EMIL-code-getin/desk-robot/hardware/pan-tilt-bracket/preview.png

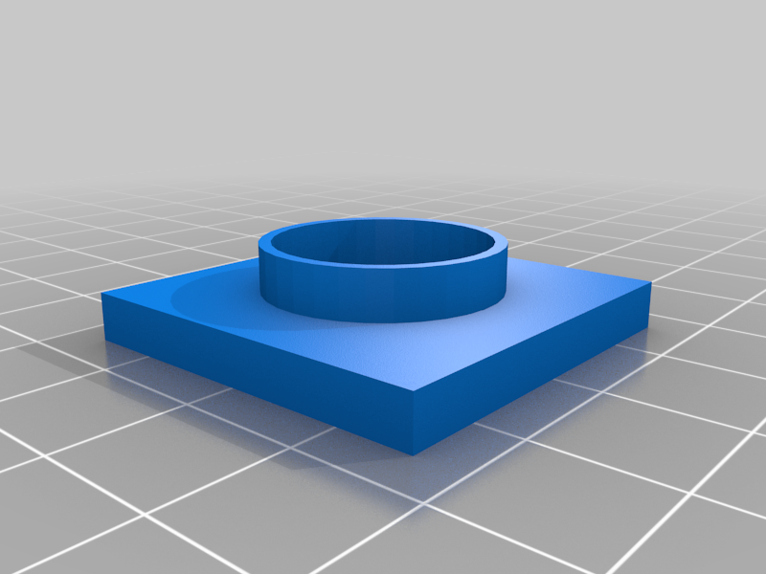
hardware/pan-tilt-bracket/preview.png
