EMIL-code-getin/desk-robot/README.md

# desk-robot

A small desk robot with a face, a voice, and a camera. Say "hey Rocky" and it
turns its head, looks at you, and answers out loud in character. The body is
a $24 microcontroller with an OLED screen on a pan-tilt neck. The brain is a
Python program on your computer that does speech-to-text, asks a language model,
and speaks the reply through the robot's speaker.

<!-- photo or short clip goes here: docs/rocky.jpg -->

## Versions

**V1 is the robot in the videos.** It is frozen as the
[v1.0 release](https://github.com/cgro00/desk-robot/releases/tag/v1.0), a
permanent snapshot of the code, wiring, and parts list as built. `main` is
always the latest version and may be ahead of what an older video shows.
[CHANGELOG.md](CHANGELOG.md) lists what changed between versions.

Out of the box it is **Rocky**, the Eridian engineer from *Project Hail
Mary*: short sentences, "question" and "answer", "amaze", and constant
worry about whether you have slept. Everything about him is yours to change.
See [Make it your own](#make-it-your-own).

**What it can do**

- Wake on its name, listen, and answer with a spoken reply in a cloned voice.
- Show seven expressions on its face, blink, and doze off when ignored.
- Turn and nod its head, follow your face, and look where you ask.
- See through its camera and tell you what is there, honestly.
- Decide when you have finished talking, the way a person does, instead of
  waiting for a fixed pause.

**How it is put together**

```
┌──────────────── the robot (XIAO ESP32S3 Sense) ───────────────┐
│  OLED face · pan/tilt servos · camera · mic · amp + speaker   │
└───────────────────────────┬───────────────────────────────────┘
                            │ WiFi (WebSocket)
┌───────────────────────────┴───────────────────────────────────┐
│  brain server (Python, on your computer)                      │
│  wake word → speech-to-text → language model → text-to-speech │
│  plus face tracking, emotions, and head movements             │
└───────────────────────────────────────────────────────────────┘
```

The firmware is deliberately simple: it draws the face, moves the servos,
and streams audio and camera frames. All the judgement lives in `server/`.
Nothing is billed while the robot is idle.

## Contents

1. [What you need](#what-you-need)
2. [Build the body](#build-the-body)
3. [Flash the firmware and test over USB](#flash-the-firmware-and-test-over-usb)
4. [Set up the brain on your computer](#set-up-the-brain-on-your-computer)
5. [Connect the robot to the brain](#connect-the-robot-to-the-brain)
6. [Living with Rocky](#living-with-rocky)
7. [Make it your own](#make-it-your-own)
8. [Troubleshooting](#troubleshooting)
9. [How it works](#how-it-works)
10. [Privacy and security](#privacy-and-security)
11. [Credits and license](#credits-and-license)

## What you need

**Parts.** Roughly $100 in total, plus a soldering iron if you do not have
one. Everything is a common Amazon or Adafruit item.

| Part | Notes |
| --- | --- |
| Seeed XIAO ESP32S3 **Sense** | The Sense version has the camera and microphone built in. Get it with headers pre-soldered if you can. The little U.FL antenna in the box is required for WiFi. |
| 1.3" SH1106 I2C OLED, 128x64 | The face. The 0.96" SSD1306 also works with a one-line firmware change. |
| Adafruit Mini Pan-Tilt kit, assembled | The neck. It ships with two SG90 servos, which work. MG90S metal-gear servos are a drop-in upgrade for smoother motion. |
| MAX98357A I2S amplifier board | Turns digital audio into speaker power. The $3 clones work. |
| Small 4 Ω 3 W speaker | Enclosed ones with a JST lead are easiest to mount. |
| 470 to 1000 µF electrolytic capacitor | Keeps the servos from browning out the board. Not optional. |
| Breadboard, jumper wires, M2/M2.5 nylon standoffs | For wiring and mounting the screen. |
| 5 V, 2 A or better USB-C power supply | A laptop port is fine for flashing, not for running servos and speaker. |

**On the computer side.**

- A Mac, Windows PC, or Linux machine on the same WiFi as the robot. It was
  built and tested on an Apple Silicon Mac. Windows and Linux use the same
  code except for the built-in fallback voice and speaker playback, which
  have their own paths that nobody has run yet. If you're the first, say how
  it went. On Linux, install `espeak-ng` for the fallback voice.
- Python 3.13, which is what this was built and tested with.
- PlatformIO for flashing the firmware (installed below).
- A language-model API key. Any one of these works:
  - **OpenRouter** (the default): one key, any model, easy to switch.
  - **Anthropic**: use a Claude model directly.
  - **OpenAI**: use a GPT model directly.
- Optionally a **Fish Audio** key for the cloned voice. Without it Rocky
  speaks with your computer's built-in voice, which is fine for getting
  started.

**Skills.** Basic soldering (about 27 joints, all through-hole), and the
patience to read the wiring guide before powering anything on.

## Build the body

Follow [`docs/wiring.md`](docs/wiring.md) with the parts in hand. The short
version:

1. Everything shares a ground rail.
2. Servos and the amplifier run from the XIAO's **5 V** pin, never 3.3 V.
3. The big capacitor goes across 5 V and ground, striped leg to ground.
4. The OLED is on I2C (D4/D5), the servos on D3 (pan) and D6 (tilt), the
   amplifier on D0, D1, D2.
5. The camera and microphone are on the Sense board already. No wiring.

Only the OLED and the XIAO ride on the pan-tilt head. The amplifier,
speaker, breadboard, and capacitor stay on the desk. There is no printed
shell yet, so mount the screen on a small plate on the tilt platform with
standoffs or foam tape, with the camera peeking over the top edge.

## Flash the firmware and test over USB

Do this before WiFi. It proves the face and the neck work.

1. Install PlatformIO, either as the VS Code extension or from the terminal:

   ```bash
   brew install platformio
   ```

2. Plug the XIAO in over USB-C, then build and flash:

   ```bash
   cd firmware
   pio run -t upload
   pio device monitor        # serial console at 115200
   ```

3. The eyes should open, blink, and look around on their own. In the serial
   console, try:

   ```
   help                 list commands
   emo happy            change the face: neutral/happy/sad/angry/surprised/sleepy/thinking
   pan -30              turn the head, -60..60, 0 = center
   tilt -20             nod the head, -60 (down)..0 (level)
   blink                blink once
   demo off             stop the idle behaviour
   raw tilt 20          calibration move that ignores the limits (watch it!)
   ```

4. Check the head's manners. If `tilt -20` looks up instead of down, flip
   `TILT_INVERT` in `firmware/include/config.h`. If the head is not straight
   or level at 0, adjust `PAN_TRIM_DEG` and `TILT_TRIM_DEG` a few degrees at
   a time. If the tilt bracket strains at the end of its travel, pull the
   `TILT_MIN_DEG` and `TILT_MAX_DEG` limits in. Re-flash after each change.

Without a `secrets.h` file the firmware stays in this USB-only mode, which
is useful whenever you want to test the body alone.

## Set up the brain on your computer

The brain works without the robot: it uses your computer's microphone and
speaker until the robot connects. Get it talking first.

```bash
cd server
python3 -m venv .venv
source .venv/bin/activate          # Windows: .venv\Scripts\activate
pip install -r requirements.txt
cp .env.example .env               # Windows: copy .env.example .env
```

Open `server/.env` and fill in:

- `LLM_API_KEY`: your OpenRouter key. (For Anthropic or OpenAI instead, see
  [Change the model or provider](#change-the-model-or-provider).)
- `HUMAN_NAME`: what Rocky should call you.
- `ROBOT_TOKEN`: any random string. The robot will need the same one. Make
  one with `python3 -c "import secrets; print(secrets.token_hex(16))"`.
- `FISH_AUDIO_API_KEY`: optional, for the cloned voice.

Then start it, from the `server` folder with the venv active:

```bash
python -m brain.main
```

The first run downloads about 160 MB of speech models into `~/.cache`
(Whisper from Hugging Face, the two turn-detection models from GitHub and
Hugging Face, all pinned to a fixed version). macOS will ask once to let
your terminal use the microphone; on Windows, check that microphone access
for desktop apps is on in Privacy settings. Say **"hey Rocky, what is a
weekend?"** and he should answer through your computer's speaker. You can
also type `ask what is a weekend?` into the server console.

The live view at <http://localhost:8766/> is Rocky's console: what he sees,
what he hears, the last exchange, and controls for his head, face, voice,
sleep, and listening. It only answers this computer.

## Connect the robot to the brain

1. Find your computer's address on your WiFi:

   ```bash
   ipconfig getifaddr en0     # macOS
   ipconfig                   # Windows: the IPv4 address of your WiFi adapter
   hostname -I                # Linux
   ```

   Your router can usually pin the computer to a fixed address so this does
   not change.

2. Copy `firmware/include/secrets.h.example` to `secrets.h` in the same
   folder and fill in your WiFi name and password, that address, and
   the same `ROBOT_TOKEN` you put in `server/.env`. The ESP32 only sees
   **2.4 GHz** networks.

3. Flash again with `pio run -t upload`. The serial console shows
   `wifi: connected` and then `brain: connected` once the server is running.

From then on the server listens through the robot's microphone and speaks
through the robot's speaker whenever the robot is connected, and falls back
to your computer when it is not. The robot can now live on a wall supply
away from the computer.

## Living with Rocky

| Say | What happens |
| --- | --- |
| "hey Rocky" | He wakes, looks up, and waits for your question. His name alone, without "hey", does not wake him. |
| anything, while he is awake | He answers. No need to repeat his name for about a minute. |
| "Rocky, look left" / "look at the door" | He turns his head, takes a fresh picture, and tells you what he sees. |
| "what do you see?" | He describes the current camera frame, and only what is actually in it. |
| "track me" / "stop tracking" | His head follows your face, or stops. |
| "Rocky, sleep" / "goodnight" | He says goodnight and stops listening until you say his name. |

He decides you are finished the way a person does. A small model listens to
how your sentence ends; if you sound done he answers about a third of a
second later, and if you trail off he waits. His first sentence is spoken
while the rest is still being written. If you start talking again before he
speaks, he drops the reply and answers the whole thing once. Once he is
speaking he finishes the line, because his microphone is muted while his
own voice plays.

Server console commands, for when talking is inconvenient:

```
ask <question>       talk to Rocky from the keyboard
say <text>           speak exactly this
volume 0.5           speaker volume, 0 to 1
listen               toggle the microphone
mic                  three-second level meter
track on|off         face tracking
emo surprised        push a face
pan 20 / tilt -20    move the head
status               what is connected
```

Every reply prints a `timing` line so you can see where the seconds go.

## Make it your own

Everything below is a one-file edit. None of it needs the robot plugged in,
so you can tune the character with `ask` in the server console before the
body is even built.

### Rename the robot

`ROBOT_NAME` in `server/brain/config.py`. The wake word becomes "hey
<name>" and the sleep phrases and speech-to-text hint follow automatically.
Update `WAKE_PHRASES` in the same file with the ways speech-to-text tends
to mishear the new name (say it a few times and watch the console). The
character file still introduces itself as Rocky, so edit
`server/brain/personality.py` too, or you have a robot called Bolt who
insists he is Rocky.

### Change the character

`server/brain/personality.py` is the whole personality: one system prompt
that pins down who he is and how he talks, plus a few canned lines for
waking, sleeping, and tracking. To make a different character, rewrite the
prompt. The parts worth keeping are the rules about being honest with the
camera, the emotion tag at the start of every reply, and the sentence
limit, because the face, the voice, and the cost all depend on them. Add
real exchanges that came out well to the examples at the bottom; they do
more than the rules do.

`REPLY_MAX_SENTENCES` in `config.py` caps how much he says per turn. The
server cuts anything past it before it is spoken.

### Change the voice

Rocky's voice is a community-uploaded fan clone on
[Fish Audio](https://fish.audio), not something this project owns. It may
disappear one day, and it is for personal use. Open any voice's page there,
copy the 32-character ID from the URL into `TTS_VOICE_ID` in `config.py`,
and put your Fish key in `server/.env`.
`TTS_TEMPERATURE` and `TTS_TOP_P` trade steadiness for expressiveness.
Without a Fish key he uses the computer's built-in voice: on macOS,
`TTS_FALLBACK_VOICE` picks one (`say -v ?` lists them); Windows uses its
default voice; Linux uses `espeak-ng` if installed.

The robot's speaker is tiny, so a deep voice turns into rattle. Three knobs
in `config.py` shape the audio before it reaches the speaker: `TTS_LEVEL`
(loudness he is held to), `TTS_HIGHPASS_HZ` (bass cut, try 250 to 350 for a
deep voice), and `TTS_PRESENCE_DB` (lift for a muffled voice). The console
page has sliders for all three so you can dial them in while he talks, then
copy the winners into config. If a voice keeps misbehaving, `DEBUG_SAVE_TTS`
in `config.py` keeps the last 30 spoken clips and their text in
`server/debug/tts/` (git-ignored) so you can listen back.

### Change the model or provider

The brain speaks the OpenAI-style chat API, which OpenRouter, Anthropic, and
OpenAI all serve. Pick one in `config.py`:

| Provider | `LLM_BASE_URL` | `MODEL` example | Key in `.env` |
| --- | --- | --- | --- |
| OpenRouter (default) | `https://openrouter.ai/api/v1` | `anthropic/claude-haiku-4.5` | OpenRouter key |
| Anthropic | `https://api.anthropic.com/v1/` | `claude-haiku-4-5` | Anthropic key |
| OpenAI | `https://api.openai.com/v1` | `gpt-4.1-mini` | OpenAI key |

Whichever you choose, the key goes in `LLM_API_KEY` in `server/.env`. The
model must accept images (Rocky sends camera frames) and tool calls (he
moves his head with them). A small, fast model is the right choice here:
replies are three sentences, and character matters more than reasoning.
Haiku has been the best at staying in character; a few dollars a month
covers a lot of chatting. The project was built and tested through
OpenRouter. Anthropic documents streaming, tool calls, and image input on
its OpenAI-compatible endpoint, which is everything this project uses, but
describes it as a compatibility layer rather than the main road.

### Change how he listens

Also in `config.py`: `VAD_THRESHOLD` (how loud counts as speech),
`TURN_THRESHOLD` and `TURN_MAX_SILENCE` (how sure he needs to be that you
are done, and how long he will wait), `AWAKE_SECONDS` (how long he stays
awake after you speak), `STT_MODEL` (`base.en` is fast; `small.en` hears
better and takes about a second longer), and `MIC_DEVICE` in `.env` if the
computer should use a specific microphone. The console page has sliders for the
listening knobs; changes apply immediately and last until restart.

### Change the body

`firmware/include/config.h` has the pin map, the head's range and speed
limits, servo trims, speaker volume, microphone gain, and camera flips. The
OLED driver line is near the top of `firmware/src/main.cpp` if you use a
different panel. The expressions themselves are drawn in `face.cpp`.

## Troubleshooting

- **The OLED stays black.** SDA and SCL are swapped, or a jumper is loose.
- **The board reboots when the head moves.** The servos are on 3.3 V, or the
  capacitor is missing, or you are on a laptop USB port. Use a 5 V 2 A supply.
- **`wifi: joining` forever.** The network is 5 GHz only, or the antenna is
  not clipped on. Make a 2.4 GHz network or band.
- **The robot prints `brain: connected` then `brain: disconnected, will
  retry` every few seconds.** `ROBOT_TOKEN` differs between `server/.env`
  and `secrets.h`. The server console shows the refusal. If it never gets
  to `brain: connected`, the computer's address changed or the server is
  not running.
- **He never hears you on the computer.** On macOS, check System Settings,
  Privacy & Security, Microphone for your terminal; on Windows, the
  microphone privacy setting for desktop apps. Run `mic` in the server console
  for a level meter. If you have several inputs, set `MIC_DEVICE` in `.env`.
- **"Brain has no key."** `LLM_API_KEY` is empty, or belongs to a different
  provider than `LLM_BASE_URL`.
- **He answers in the computer's voice.** `FISH_AUDIO_API_KEY` is missing
  or the voice ID is wrong. Fine for testing; set it when you want the real
  voice.
- **"cannot speak: no built-in voice on this system."** Linux without
  `espeak-ng`. Install it, or set a Fish key.
- **The voice rattles or sounds muffled.** Use the speaker-tuning sliders on
  the console page, then copy the values into `config.py`.
- **He cuts you off, or waits too long.** Raise `TURN_THRESHOLD` if he jumps
  in early, lower it if he waits. `TURN_MAX_SILENCE` is his patience limit.
- **First start is slow.** It is downloading the speech models. Only once.

## How it works

- **Firmware** (`firmware/src/`): `face.cpp` draws the eyes and mouth at 30
  fps, `servo_neck.cpp` eases the head with speed limits, `camera.cpp`
  keeps the latest JPEG in memory, `mic.cpp` streams 16 kHz audio, and
  `speaker.cpp` plays whatever the brain sends. `link.cpp` is the WebSocket
  client. The USB serial console and the brain drive the same commands.
- **Brain** (`server/brain/`): `ears.py` turns audio into text with
  faster-whisper, using Silero VAD to find speech and Smart Turn
  (`turn.py`) to decide when you have finished. `thinking.py` talks to the
  model, streams the reply sentence by sentence, and gives the model two
  tools: `look` (move the head, take a picture) and `track_face`.
  `mouth.py` turns text into audio with Fish Audio and levels it for the
  small speaker. `tracker.py` follows faces with OpenCV. `eyes.py` serves
  the console page. `main.py` ties it together.
- **Protocol** between the two is in [`docs/protocol.md`](docs/protocol.md):
  JSON commands one way, audio and JPEG frames the other.

Tests run with no hardware and no downloads:

```bash
cd server && python -m unittest tests/test_personality.py tests/test_segmenter.py
```

## Privacy and security

- **Secrets stay in two git-ignored files**: `server/.env` and
  `firmware/include/secrets.h`. Never commit them, and do not share
  `firmware/.pio/` build output either: the compiled binary contains your
  WiFi password.
- **Only your robot can talk to the brain.** The WebSocket port is open on
  your LAN, but the first message must carry `ROBOT_TOKEN`. One robot at a
  time.
- **The camera console is this computer only** and rejects requests from other
  hosts. Opening it to the LAN would let anyone on your WiFi watch the
  camera and read transcripts.
- **Voice is unauthenticated by design.** Anyone in earshot can say "hey
  Rocky". All he can do is move his head and spend a fraction of a cent.
- **What leaves your computer:** each question sends the transcript, the recent
  conversation, your name from `HUMAN_NAME`, and the newest camera frame
  (only for visual questions) to your model provider, and each reply's text
  to Fish Audio if configured. Speech-to-text and face tracking run
  locally. The first run downloads speech models from Hugging Face and
  GitHub, pinned to fixed versions. The console page loads nothing from the
  internet.
- **What is stored:** the in-memory conversation, and nothing else unless
  you turn on `DEBUG_SAVE_TTS` or `DEBUG_SAVE_UTTERANCE` in `config.py`,
  which keep recent spoken replies or the last thing heard in
  `server/debug/` (git-ignored).
- **Known limitation:** robot-to-computer traffic is a plain WebSocket on
  your home network. Someone already on your WiFi who spoofs the computer's address
  could command the robot and receive its streams. Mutual authentication or
  TLS is the fix if that matters to you.

## Credits and license

- Face detection is [YuNet](https://github.com/opencv/opencv_zoo/tree/main/models/face_detection_yunet)
  (`server/models/`), Apache 2.0, by Shiqi Yu and the OpenCV Zoo
  contributors.
- Speech detection is [Silero VAD](https://github.com/snakers4/silero-vad)
  (MIT) and end-of-turn detection is
  [Smart Turn](https://github.com/pipecat-ai/smart-turn) (BSD-2-Clause).
  Both download on first run. `server/brain/whisper_features.py` is
  vendored from Smart Turn (Daily, BSD-2-Clause), itself derived from
  HuggingFace transformers (Apache 2.0).
- Rocky and his voice are fan work. *Project Hail Mary* belongs to Andy Weir.

MIT licensed. See [`LICENSE`](LICENSE). Build one, change everything, tell
me what it turned into.
