EMIL-code-getin/desk-robot/hardware/pan-tilt-bracket/minimalized_pan_tilt_tower_pro_9g_20_critical_update.stl

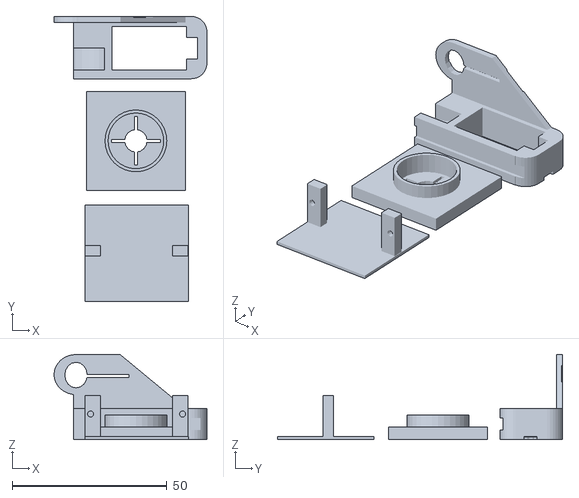
[picture p2: CAD file, 2026-09-24]
hardware/pan-tilt-bracket/minimalized_pan_tilt_tower_pro_9g_20_critical_update.stl
49.5 x 92.3 x 27.5
