EMIL-code-getin/desk-robot/hardware/pan-tilt-bracket/pan_tilt_for_tower_pro_9g_servo_sg90_base.stl

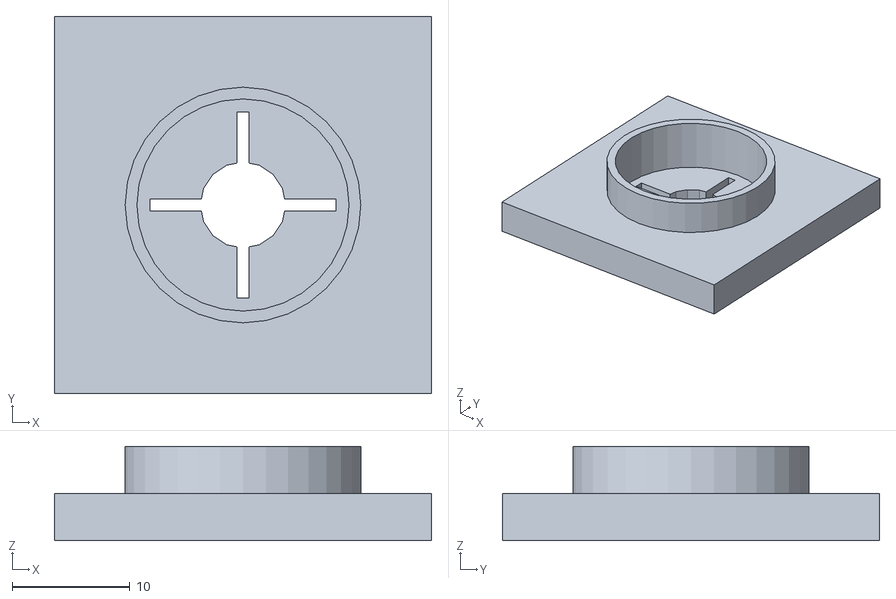
[picture p3: CAD file, 2026-09-24]
hardware/pan-tilt-bracket/pan_tilt_for_tower_pro_9g_servo_sg90_base.stl
32.0 x 32.0 x 8.00
