EMIL-code-getin/desk-robot/hardware/pan-tilt-bracket/minimalized_pan_tilt_tower_pro_9g_face.stl

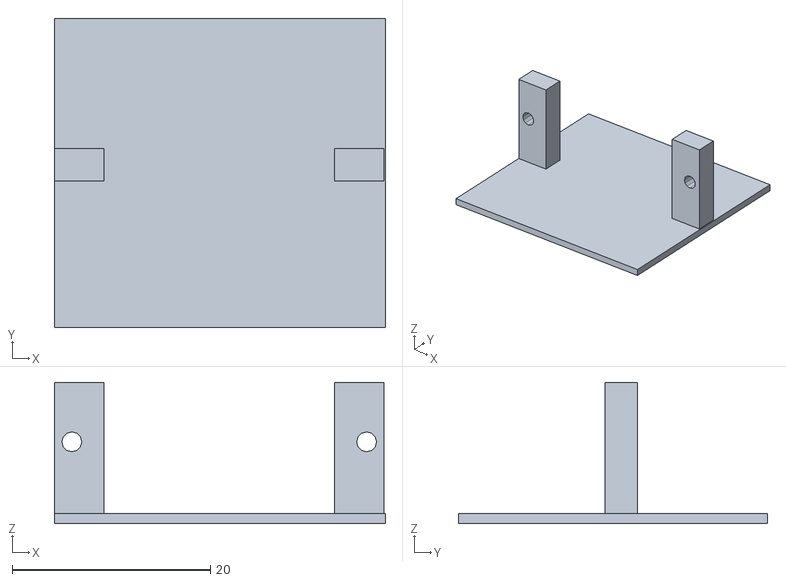
[picture p4: CAD file, 2026-09-24]
hardware/pan-tilt-bracket/minimalized_pan_tilt_tower_pro_9g_face.stl
33.4 x 31.2 x 14.3
