EMIL-code-getin/desk-robot/hardware/pan-tilt-bracket/minimalized_pan_tilt_tower_pro_9g_v20_critical_update.stl

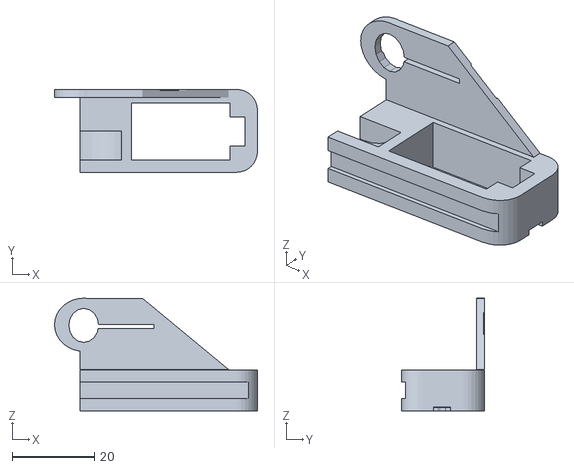
[picture p5: CAD file, 2026-09-24]
hardware/pan-tilt-bracket/minimalized_pan_tilt_tower_pro_9g_v20_critical_update.stl
49.5 x 20.3 x 27.5
