EMIL-code-getin/desk-robot/firmware/include/config.h

#pragma once

// ─── Pin map (XIAO ESP32S3 Sense) ────────────────────────────────────────────
// Silkscreen label → GPIO number. The camera, PDM mic, and SD slot on the
// Sense expansion board use their own internal pins and don't appear here.
//
//   D0  = GPIO1   I2S BCLK  → MAX98357A BCLK      (speaker)
//   D1  = GPIO2   I2S LRC   → MAX98357A LRC       (speaker)
//   D2  = GPIO3   I2S DIN   → MAX98357A DIN       (speaker)
//   D3  = GPIO4   pan servo signal (orange wire)
//   D4  = GPIO5   I2C SDA   → OLED SDA
//   D5  = GPIO6   I2C SCL   → OLED SCL
//   D6  = GPIO43  tilt servo signal (orange wire)
//   D7  = GPIO44  spare

constexpr uint8_t PIN_SERVO_PAN = 4;   // D3
constexpr uint8_t PIN_SERVO_TILT = 43; // D6

constexpr uint8_t PIN_I2S_BCLK = 1; // D0 → MAX98357A BCLK
constexpr uint8_t PIN_I2S_LRC = 2;  // D1 → MAX98357A LRC
constexpr uint8_t PIN_I2S_DIN = 3;  // D2 → MAX98357A DIN

// I2C uses the XIAO's default Wire pins (SDA=GPIO5/D4, SCL=GPIO6/D5).
// Most SH1106 modules answer at address 0x3C; U8g2 finds it automatically.

// ─── Motion limits ───────────────────────────────────────────────────────────
constexpr float PAN_MIN_DEG = -60.0f; // head turn limit, left
constexpr float PAN_MAX_DEG = 60.0f;  // head turn limit, right
constexpr float PAN_MAX_SPEED = 180.0f; // deg/sec ceiling — keeps motion gentle
constexpr float PAN_TRIM_DEG = 0.0f;    // tweak if the head isn't straight at 0

// The reference build: the tilt platform hits the pan servo body if it tries to
// look above eye level, so 0 (eye level) is the ceiling and it only nods down.
constexpr float TILT_MIN_DEG = -60.0f;  // look-down limit
constexpr float TILT_MAX_DEG = 0.0f;    // look-up limit (eye level is the mechanical stop)
constexpr float TILT_MAX_SPEED = 120.0f;
constexpr float TILT_TRIM_DEG = 0.0f;   // tweak so the head sits level at 0
constexpr bool TILT_INVERT = true;      // flip if `tilt -20` looks up instead of down
                                        // (true on the Adafruit pan-tilt with the OLED facing forward)

// Watch the mechanism the first time tilt moves: if the bracket strains at
// either end of travel, pull TILT_MIN/MAX in until it stops.

// Detach the servo after it has been at rest this long. A detached servo
// doesn't buzz or burn power; the head is light enough to hold position.
constexpr uint32_t SERVO_RELAX_MS = 1500;

// ─── Microphone ──────────────────────────────────────────────────────────────
// The Sense board's PDM mic is hard-wired to these GPIOs (no header pins).
constexpr uint8_t PIN_PDM_CLK = 42;
constexpr uint8_t PIN_PDM_DATA = 41;
// Software gain on the mic samples. The PDM mic is quiet; raise if the brain
// says "too quiet", lower if loud speech clips.
constexpr float MIC_GAIN = 6.0f;

// ─── Camera ──────────────────────────────────────────────────────────────────
// The camera is mounted ribbon-up on the head, which puts the sensor upside
// down: flip + mirror = rotate 180 degrees.
constexpr bool CAMERA_VFLIP = true;
constexpr bool CAMERA_HMIRROR = true;

// ─── Speaker ─────────────────────────────────────────────────────────────────
// 0.0-1.0 software volume for the MAX98357A. For more than 1.0 can give,
// tie the amp's GAIN pin to GND (15 dB instead of the floating 9 dB).
constexpr float SPEAKER_VOLUME = 0.7f;

// ─── Behavior ────────────────────────────────────────────────────────────────
constexpr uint32_t FRAME_INTERVAL_MS = 33; // ~30 FPS face animation
