EMIL-code-getin/desk-robot/firmware/src/face.h

#pragma once

#include <Arduino.h>
#include <U8g2lib.h>

// Expressive two-eye face for a 128x64 mono OLED.
//
// Eyes are rounded rectangles whose shape morphs smoothly between emotion
// presets. Layered on top: blinks, gaze shifts, a glint in each eye, a mouth
// that moves with the speaker's audio, per-emotion flourishes ("!" pop,
// blush, tears, thinking dots, angry shake), and a sleep state with slow
// breathing and floating Z's.

enum class Emotion : uint8_t {
  Neutral,
  Happy,
  Sad,
  Angry,
  Surprised,
  Sleepy,
  Thinking,
  COUNT,
};

const char* emotionName(Emotion e);
bool emotionFromName(const char* name, Emotion& out);

class Face {
 public:
  explicit Face(U8G2& display) : u8g2_(display) {}

  void begin();
  void setEmotion(Emotion e);
  Emotion emotion() const { return emotion_; }
  void blink();

  // Asleep: eyes shut, breathing, Z's. Overrides the emotion while on.
  void setAsleep(bool on);
  bool asleep() const { return asleep_; }

  // Talking: draws a mouth that opens with `level` (0..1, the speaker's
  // current loudness). Call every frame while audio plays.
  void setTalking(bool on, float level = 0.0f);

  // When idle behavior is on, the face blinks and glances around on its own.
  void setIdle(bool on) { idle_ = on; }

  // Call every frame: advances animation, then renders.
  void update(uint32_t nowMs);

 private:
  // The morphable parameters of one emotion. All units are pixels.
  struct Params {
    float eyeW;      // eye width
    float eyeH;      // eye height
    float radius;    // corner rounding
    float browSlant; // top edge tilt: >0 inner corners drop (angry), <0 outer (sad)
    float lowerLid;  // pushes up from below → happy crescent
    float upperLid;  // droops from above → sleepy
  };

  struct Zed {
    bool alive = false;
    float x = 0, y = 0;
    float age = 0;  // 0..1 over its life
  };

  static Params paramsFor(Emotion e);
  void stepAnimation(uint32_t nowMs);
  void render();
  void drawEye(int cx, int cy, bool isLeft, float hScale);
  void drawMouth(int cx, int cy);
  void drawFlourishes(int leftCx, int rightCx, int cy, int eyeTop, int eyeBottom);
  void drawZeds();

  U8G2& u8g2_;
  Emotion emotion_ = Emotion::Neutral;
  Params cur_ = paramsFor(Emotion::Neutral);
  Params target_ = paramsFor(Emotion::Neutral);
  uint32_t emotionSinceMs_ = 0;

  // Blink state: 0 = open, 1 = fully closed.
  float blinkAmount_ = 0.0f;
  bool blinkClosing_ = false;
  uint32_t nextBlinkMs_ = 0;

  // Gaze offset from center, eased toward gazeTarget.
  float gazeX_ = 0, gazeY_ = 0;
  float gazeTargetX_ = 0, gazeTargetY_ = 0;
  uint32_t nextSaccadeMs_ = 0;

  // Flourish state.
  float pop_ = 0.0f;            // overshoot on emotion change, decays to 0
  float squint_ = 0.0f;         // 1 while squinting, decays
  uint32_t nextSquintMs_ = 0;
  float tearY_ = -1.0f;         // -1 = no tear; else its y
  uint32_t nextTearMs_ = 0;
  uint8_t thinkDots_ = 0;
  uint32_t nextDotMs_ = 0;
  int jitterX_ = 0;

  // Sleep.
  bool asleep_ = false;
  float breath_ = 0.0f;         // phase
  Zed zeds_[3];
  uint32_t nextZedMs_ = 0;
  uint32_t nextTwitchMs_ = 0;
  float twitch_ = 0.0f;

  // Mouth.
  bool talking_ = false;
  float mouthLevel_ = 0.0f;
  float mouth_ = 0.0f;          // eased openness 0..1

  bool idle_ = true;
  uint32_t lastFrameMs_ = 0;
  uint32_t frame_ = 0;
};
