EMIL-code-getin/desk-robot/(commit log)

2026-09-06 Rocky: desk robot with face, voice, camera, and a Claude brain
    First commit of the working robot. XIAO ESP32S3 Sense on a pan-tilt neck
    with an OLED face, MAX98357A speaker, PDM mic, and camera; a Python brain
    server on the Mac does wake word, speech-to-text, Claude Haiku 4.5 via
    OpenRouter, Fish Audio voice, live camera view, and face tracking.
    Firmware (PlatformIO, firmware/):
    - face: morphing eyes, blinks, glints, mouth driven by speaker level,
    per-emotion flourishes, sleep state with breathing and Z's
    - servos: pan/tilt easing with idle glances and auto-relax; tilt capped
    at eye level for this build
    - link: WiFi + WebSocket to the brain, shared-token hello, JSON commands
    mapped on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
2026-09-07 Rocky talks like a conversation: streaming replies, real turn detection, head fixes
    Server
    - Replies stream end to end: the model's sentences go to Fish Audio one at a
    time, Fish's PCM streams to the robot as it is generated (speak_begin with
    bytes 0), and the face changes before the first sentence. First sound now
    arrives ~1.7 s after the question instead of ~4-5 s.
    - Turn detection replaces the fixed 0.9 s silence wait: Silero VAD decides
    what is speech and Smart Turn v3.2 judges after a 0.2 s pause whether you
    sound finished, waiting up to TURN_MAX_SILENCE if you trail off. Both are
    small ONNX models (new brain/turn.py, numpy Whisper features vendored from
    Pipecat under BSD-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
    [config.h, main.cpp, servo_neck.cpp, servo_neck.h]
2026-09-07 Live-view console, honest camera answers, level voice, head fixes
    - New live view (brain/liveview.html, served by eyes.py): a Hail Mary style
    console showing what Rocky sees (reticle follows head pose, red glow while
    he speaks), a rolling "Rocky hears" sound strip, the last exchange, and
    controls for head, face, voice, sleep and listening tuning. Controls go
    through POST /api/<action>, guarded by the Host check plus a custom header
    and Origin check so no other site can drive the robot. Tunable config keys
    are allowlisted (main.py TUNABLE) and change live until restart.
    - Camera answers are honest: a picture is attached only for questions that
    are actually about seeing (C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
    [main.cpp, servo_neck.cpp]
2026-09-18 Rocky only again, plus public-release prep
    - Remove the TARS persona and all switching (spoken "switch to", the
    console `be` command, the live-view Who card). Rocky's prompt and
    canned lines are the single character again. The speaker tuning that
    came with that work stays as flat config knobs (TTS_LEVEL,
    TTS_HIGHPASS_HZ, TTS_PRESENCE_DB) with the console sliders.
    - HUMAN_NAME is read from server/.env (default "friend") so a real name
    never lands in the repo.
    - MIT license, README credits for YuNet / Silero VAD / Smart Turn, and
    the stray tool session file ignored.
    - Ears: a missing Mac mic no longer stops the robot mic from working;
    softer threshold once speech has started so q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
    [config.h, main.cpp]
2026-09-18 Public-release audit fixes
    - A blank value in server/.env no longer shadows the default, so a fresh
    copy of .env.example starts the server instead of crashing it.
    - Model provider is configurable (LLM_BASE_URL + MODEL in config.py,
    LLM_API_KEY in .env): OpenRouter by default, Anthropic or OpenAI direct.
    - Privacy: debug clip saving off by default; console page loads nothing
    from the internet (system fonts, no-referrer); Whisper model pinned to a
    fixed commit like the other two; README lists everything that leaves the
    Mac and what is stored.
    - Hardening: token compared as bytes, Content-Length range-checked,
    temperature coerced to a number, nosniff on image responses.
    - MIC_DEVICE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
    [config.h, link.h, main.cpp]
2026-09-18 Run the brain on Windows and Linux too
    - Built-in fallback voice picks the engine by platform: macOS `say`,
    Windows' speech engine through PowerShell, espeak-ng on Linux. A clear
    "cannot speak" message when none exists, instead of a crash. Text still
    goes in on stdin.
    - Speaker playback when the robot is offline uses sounddevice off macOS;
    the Mac keeps afplay because of the CoreAudio conflict with the mic.
    - README: what you need covers all three systems (tested on a Mac only,
    Windows and Linux paths untested), with per-platform notes for venv
    activation, the IP lookup, microphone permission, and the fallback voice.
    Secrets template gives the IP command for each system.
    Co-Au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
2026-09-22 Speaker: stop driving the voice into the limiter
    TTS_LEVEL went from 0.12 to 0.26 in the release prep. Speech peaks sit
    ~14 dB above RMS, so at 0.26 every peak was being squeezed by the soft
    limiter and the amp ran near its rails: crackly and muffled on the
    robot. Back to 0.14, plus a 150 Hz bass cut (the small speaker only
    rattles below that) and a +3 dB presence lift. Measured on a fresh
    line: samples in the limiter 3.0% -> 0.6%, near full scale 0.6% -> 0.02%.
2026-09-22 Mark V1: versions note, changelog, ignore local CAD
    V1 is frozen as the v1.0 tag and GitHub Release; main stays the latest.
    The README says so up top for people arriving from videos, CHANGELOG.md
    tracks what moves between versions, and docs/cad/ (the Fusion work for
    the V2 neck) stays out of the repo.
2026-09-22 Changelog: V1 uses SG90 servos, not MG90S
2026-09-22 Speaker: restore the original (2026-09-06) voice pipeline
    The Sept 17 release prep raised TTS_LEVEL 0.12 -> 0.26, TTS_MAX_GAIN
    6 -> 8, and replaced the peak limiter (turn a loud chunk down so its
    peak stays under 0.95) with a tanh soft-clipper that bends peaks. That
    combination is what made Rocky crackly on the robot's speaker; the
    Sept 21 fix lowered the level but kept the clipper.
    Back to 0.12 / 6.0 and the gain-cap limiter, which never alters the
    waveform. The bass-cut and presence EQ stay available on the console
    sliders but default to off, as they effectively were then.
2026-09-24 Add 3D-printable pan-tilt bracket as alternative to the store-bought kit
    STL files (CC BY-NC, by cazantyl on Thingiverse) plus attribution/usage
    notes for printing a two-servo pan-tilt bracket instead of buying the
    assembled Adafruit/SparkFun kit. No firmware changes needed since
    pan/tilt geometry is calibrated in config.h.
    [minimalized_pan_tilt_tower_pro_9g_20_critical_update.stl, minimalized_pan_tilt_tower_pro_9g_face.stl, minimalized_pan_tilt_tower_pro_9g_v20_critical_update.stl, pan_tilt_for_tower_pro_9g_servo_sg90_base.stl]
